adafruit/Adafruit-Hallowing-M4-PCB/Adafruit HalloWing M4 Pinout.pdf

# Adafruit Hallowing M4

# https://www.adafruit.com/product/4300

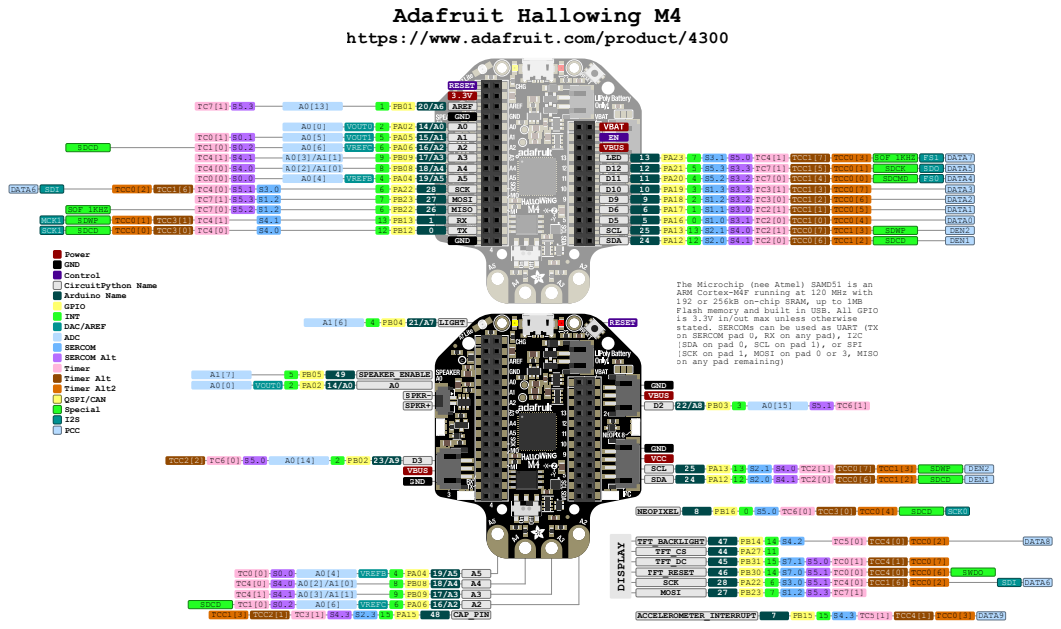
[picture p2: page 1]

The Microchip (nee Atmel) SAMD51 is an
ARM Cortex-M4F running at 120 MHz with
192 or 256kB on-chip SRAM, up to 1MB
Flash memory and built in USB. All GPIO
is 3.3V in/out max unless otherwise
stated. SERCOMs can be used as UART (TX
on SERCOM pad 0, RX on any pad), I2C
(SDA on pad 0, SCL on pad 1), or SPI
(SCK on pad 1, MOSI on pad 0 or 3, MISO
on any pad remaining)
GND
VBUS
