adafruit/Adafruit-Hallowing-M4-PCB/Adafruit Hallowing M4.sch

## EAGLE design Adafruit Hallowing M4.sch (2019-09-18)

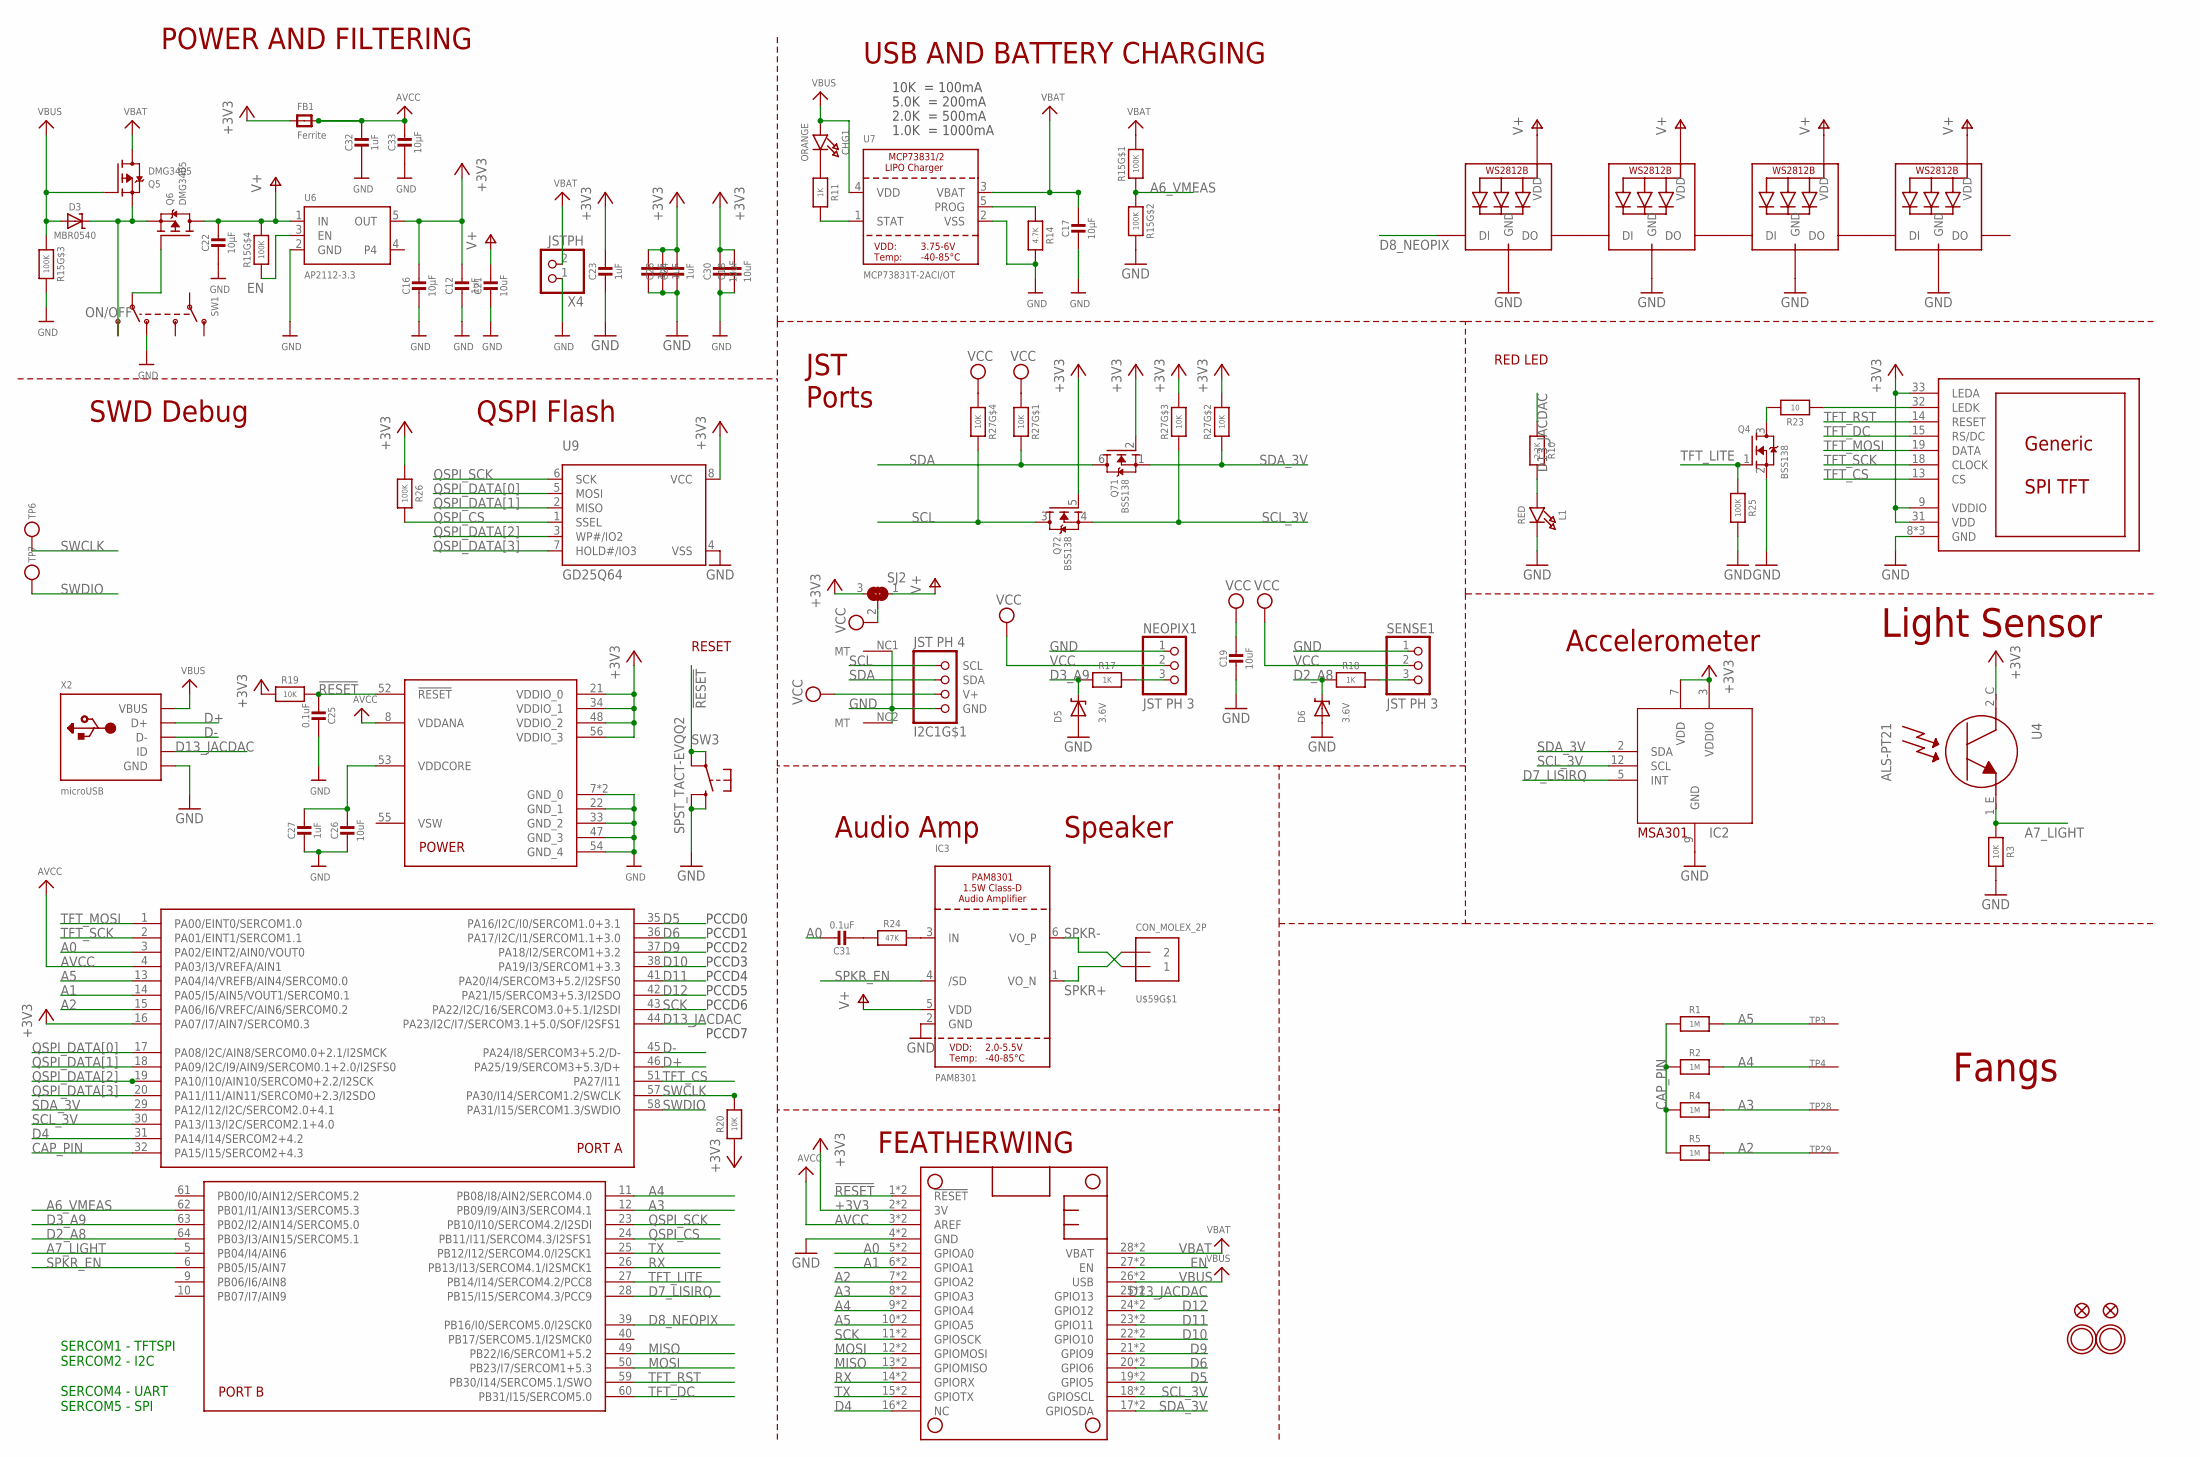
[picture p3: schematic Adafruit Hallowing M4.sch]

Parts:
C12, C23, C24, C27, C28, C29, C32: 1uF; 0603-NO
C16, C17, C22, C33: 10µF; 0805-NO
C18, C19, C21, C26, C30: 10uF; 0805-NO
C25, C31: 0.1uF; 0603-NO
CHG1: ORANGE; CHIPLED_0805_NOOUTLINE
D3: MBR0540; SOD-123
D5, D6: 3.6V; SOD-323
FB1: Ferrite; 0805-NO
I2C1: JST PH 4; JSTPH4
IC2: MSA301; LGA12_2X2MM
IC3: PAM8301; SOT23-6
L1: RED; CHIPLED_0805_NOOUTLINE
LED1, LED2, LED3, LED4: WS2812B_4020
MS2: FEATHERWING_SMTDUALNOHOLES; FEATHERWING_SMT_NOHOLES
NEOPIX1: JST PH 3; JSTPH3
Q4: BSS138; SOT23-WIDE
Q5, Q6: DMG3405; SOT23-R
Q7: BSS138; SOT363
R1, R2, R4, R5: 1M; 0603-NO
R3, R19, R20: 10K; 0603-NO
R10: 2.2K; 0603-NO
R11, R17, R18: 1K; 0603-NO
R14: 4.7K; 0603-NO
R15: 100K; RESPACK_4X0603
R23: 10; 0603-NO
R24: 47K; 0603-NO
R25, R26: 100K; 0603-NO
R27: 10K; RESPACK_4X0603
SENSE1: JST PH 3; JSTPH3
SJ2: SOLDERJUMPER_2WAY; SOLDERJUMPER_2WAY_OPEN_NOPASTE
SW1: SWITCH_DPDTEG1390; EG1390
SW3: SPST_TACT-EVQQ2; BTN_KMR2_4.6X2.8
TFT1: DISP_LCD_GENERIC_SPITFT_VDDIO_1.54_240X240_HANDSO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; TFT_1.54IN_240X240_HANDSOLDER
TP3, TP29: SEWTAP_ALLILONG; PCB_ALLI_LONG
TP4, TP28: SEWTAPPCB_ALLIGATOR; PCB_ALLI
TP6, TP7: TESTPOINTROUND1.5MM; TESTPOINT_ROUND_1.5MM
U4: ALS-PT21; ALS-PT26-21C
U6: AP2112-3.3; SOT23-5
U7: MCP73831T-2ACI/OT; SOT23-5
U9: GD25Q64; SOIC8_208MIL
U$31, U$32: MOUNTINGHOLE2.5; MOUNTINGHOLE_2.5_PLATED
U$34, U$35: FIDUCIAL_1MM
U$59: CON_MOLEX_2P; 53398-0271
U$63: ATSAMD51J19; PQFN64-1
X2: microUSB; 4UCONN_20329_V2
X4: JSTPH; JSTPH2

Connections:
!RESET: C25.2, MS2.1 (!RESET), R19.2, SW3.A, SW3.A' (P1), U$63.52 (!RESET)
+3V3: C12.1, C16.1, C18.1, C23.1, C24.1, C28.1, C29.1, C30.1, FB1.1, IC2.3 (VDDIO), IC2.7 (VDD), MS2.2 (3V), Q7.2 (G), Q7.5 (G), R19.1, R20.1, R26.1, R27.2 (1), R27.3 (1), SJ2.3, TFT1.9 (VDDIO), TFT1.31 (VDD), TFT1.33 (LEDA), U4.2_C (C), U6.5 (OUT), U9.8 (VCC), U$63.16 (PA07/I7/AIN7/SERCOM0.3), U$63.21 (VDDIO_0), U$63.34 (VDDIO_1), U$63.48 (VDDIO_2), U$63.56 (VDDIO_3)
A0: C31.1, MS2.5 (GPIOA0), U$63.3 (PA02/EINT2/AIN0/VOUT0)
A1: MS2.6 (GPIOA1), U$63.14 (PA05/I5/AIN5/VOUT1/SERCOM0.1)
A2: MS2.7 (GPIOA2), R5.1, TP29.P$1, U$63.15 (PA06/I6/VREFC/AIN6/SERCOM0.2)
A3: MS2.8 (GPIOA3), R4.1, TP28.P$1, U$63.12 (PB09/I9/AIN3/SERCOM4.1)
A4: MS2.9 (GPIOA4), R2.1, TP4.P$1, U$63.11 (PB08/I8/AIN2/SERCOM4.0)
A5: MS2.10 (GPIOA5), R1.1, TP3.P$1, U$63.13 (PA04/I4/VREFB/AIN4/SERCOM0.0)
A6_VMEAS: R15.1, R15.2 (1), U$63.62 (PB01/I1/AIN13/SERCOM5.3)
A7_LIGHT: R3.2, U4.1_E (E), U$63.5 (PB04/I4/AIN6)
AVCC: C32.1, C33.1, FB1.2, MS2.3 (AREF), U$63.4 (PA03/I3/VREFA/AIN1), U$63.8 (VDDANA)
CAP_PIN: R1.2, R2.2, R4.2, R5.2, U$63.32 (PA15/I15/SERCOM2+4.3)
CHG_LED1: R11.2, U7.1 (STAT)
CHG_RATE1: R14.1, U7.5 (PROG)
D2: R18.1, SENSE1.3
D2_A8: D6.C, R18.2, U$63.64 (PB03/I3/AIN15/SERCOM5.1)
D3: NEOPIX1.3, R17.1
D3_A9: D5.C, R17.2, U$63.63 (PB02/I2/AIN14/SERCOM5.0)
D4: MS2.16 (NC), U$63.31 (PA14/I14/SERCOM2+4.2)
D5: MS2.19 (GPIO5), U$63.35 (PA16/I2C/I0/SERCOM1.0+3.1)
D6: MS2.20 (GPIO6), U$63.36 (PA17/I2C/I1/SERCOM1.1+3.0)
D7_LISIRQ: IC2.5 (INT), U$63.28 (PB15/I15/SERCOM4.3/PCC9)
D8_NEOPIX: LED2.1 (DI), U$63.39 (PB16/I0/SERCOM5.0/I2SCK0)
D9: MS2.21 (GPIO9), U$63.37 (PA18/I2/SERCOM1+3.2)
D10: MS2.22 (GPIO10), U$63.38 (PA19/I3/SERCOM1+3.3)
D11: MS2.23 (GPIO11), U$63.41 (PA20/I4/SERCOM3+5.2/I2SFS0)
D12: MS2.24 (GPIO12), U$63.42 (PA21/I5/SERCOM3+5.3/I2SDO)
D13_JACDAC: MS2.25 (GPIO13), R10.1, U$63.44 (PA23/I2C/I7/SERCOM3.1+5.0/SOF/I2SFS1), X2.ID
D+: U$63.46 (PA25/19/SERCOM3+5.3/D+), X2.D+
D-: U$63.45 (PA24/I8/SERCOM3+5.2/D-), X2.D-
EN: MS2.27 (EN), R15.4 (1), U6.3 (EN)
GND: C12.2, C16.2, C17.2, C18.2, C19.2, C21.2, C22.2, C23.2, C24.2, C25.1, C26.2, C27.2, C28.2, C29.2, C30.2, C32.2, C33.2, D5.A, D6.A, I2C1.1 (GND), I2C1.NC1 (MT), I2C1.NC2 (MT), IC2.9 (GND), IC3.2 (GND), L1.C, LED1.4 (GND), LED2.4 (GND), LED3.4 (GND), LED4.4 (GND), MS2.4 (GND), NEOPIX1.1, Q4.2 (S), R3.1, R14.2, R15.6 (2), R15.7 (2), R25.2, SENSE1.1, SW1.O2, SW3.B (S), SW3.B' (S1), TFT1.8 (GND), U6.2 (GND), U7.2 (VSS), U9.4 (VSS), U$63.7 (GND_0), U$63.22 (GND_1), U$63.33 (GND_2), U$63.47 (GND_3), U$63.54 (GND_4), X2.BASE@1 (GND), X4.1
MISO: MS2.13 (GPIOMISO), U$63.49 (PB22/I6/SERCOM1+5.2)
MOSI: MS2.12 (GPIOMOSI), U$63.50 (PB23/I7/SERCOM1+5.3)
unnamed: R23.1, TFT1.32 (LEDK)
unnamed: L1.A, R10.2
unnamed: CHG1.C, R11.1
unnamed: D3.C, Q5.2 (S), Q6.2 (S), SW1.S2
unnamed: LED1.1 (DI), LED2.3 (DO)
unnamed: LED1.3 (DO), LED3.1 (DI)
unnamed: LED3.3 (DO), LED4.1 (DI)
unnamed: Q4.3 (D), R23.2
unnamed: C31.2, R24.1
unnamed: IC3.3 (IN), R24.2
ON/OFF: Q6.1 (G), SW1.P2
QSPI_CS: R26.2, U9.1 (SSEL), U$63.24 (PB11/I11/SERCOM4.3/I2SFS1)
QSPI_DATA[0]: U9.5 (MOSI), U$63.17 (PA08/I2C/AIN8/SERCOM0.0+2.1/I2SMCK)
QSPI_DATA[1]: U9.2 (MISO), U$63.18 (PA09/I2C/I9/AIN9/SERCOM0.1+2.0/I2SFS0)
QSPI_DATA[2]: U9.3 (WP#/IO2), U$63.19 (PA10/I10/AIN10/SERCOM0+2.2/I2SCK)
QSPI_DATA[3]: U9.7 (HOLD#/IO3), U$63.20 (PA11/I11/AIN11/SERCOM0+2.3/I2SDO)
QSPI_SCK: U9.6 (SCK), U$63.23 (PB10/I10/SERCOM4.2/I2SDI)
RX: MS2.14 (GPIORX), U$63.26 (PB13/I13/SERCOM4.1/I2SMCK1)
SCK: MS2.11 (GPIOSCK), U$63.43 (PA22/I2C/16/SERCOM3.0+5.1/I2SDI)
SCL: I2C1.4 (SCL), Q7.3 (D), R27.5 (2)
SCL_3V: IC2.12 (SCL), MS2.18 (GPIOSCL), Q7.4 (S), R27.6 (2), U$63.30 (PA13/I13/I2C/SERCOM2.1+4.0)
SDA: I2C1.3 (SDA), Q7.6 (D), R27.8 (2)
SDA_3V: IC2.2 (SDA), MS2.17 (GPIOSDA), Q7.1 (S), R27.7 (2), U$63.29 (PA12/I12/I2C/SERCOM2.0+4.1)
SPKR+: IC3.1 (VO_N), U$59.2
SPKR-: IC3.6 (VO_P), U$59.1
SPKR_EN: IC3.4 (/SD), U$63.6 (PB05/I5/AIN7)
SWCLK: R20.2, TP6.P$1, U$63.57 (PA30/I14/SERCOM1.2/SWCLK)
SWDIO: TP7.P$1, U$63.58 (PA31/I15/SERCOM1.3/SWDIO)
TFT_CS: TFT1.13 (CS), U$63.51 (PA27/I11)
TFT_DC: TFT1.15 (RS/DC), U$63.60 (PB31/I15/SERCOM5.0)
TFT_LITE: Q4.1 (G), R25.1, U$63.27 (PB14/I14/SERCOM4.2/PCC8)
TFT_MOSI: TFT1.19 (DATA), U$63.1 (PA00/EINT0/SERCOM1.0)
TFT_RST: TFT1.14 (RESET), U$63.59 (PB30/I14/SERCOM5.1/SWO)
TFT_SCK: TFT1.18 (CLOCK), U$63.2 (PA01/EINT1/SERCOM1.1)
TX: MS2.15 (GPIOTX), U$63.25 (PB12/I12/SERCOM4.0/I2SCK1)
V+: C21.1, C22.1, IC3.5 (VDD), LED1.2 (VDD), LED2.2 (VDD), LED3.2 (VDD), LED4.2 (VDD), Q6.3 (D), R15.5 (2), SJ2.1, U6.1 (IN)
VBAT: C17.1, MS2.28 (VBAT), Q5.3 (D), R15.8 (2), U7.3 (VBAT), X4.2
VBUS: CHG1.A, D3.A, MS2.26 (USB), Q5.1 (G), R15.3 (1), U7.4 (VDD), X2.VBUS
VCC: C19.1, I2C1.2 (V+), NEOPIX1.2, R27.1, R27.4 (1), SENSE1.2, SJ2.2
VDDCORE2: C26.1, C27.1, U$63.53 (VDDCORE)

Notes on the sheet:
POWER AND FILTERING
RESET
10K = 100mA
5.0K = 200mA
2.0K = 500mA
1.0K = 1000mA
USB AND BATTERY CHARGING
RED LED
Accelerometer
FEATHERWING
Audio Amp
JST Ports
PCCD0
PCCD1
PCCD2
PCCD3
PCCD4
PCCD5
PCCD6
PCCD7
Speaker
SWD Debug
QSPI Flash
Light Sensor
Fangs
SERCOM1 - TFTSPI SERCOM2 - I2C SERCOM4 - UART SERCOM5 - SPI
